accellarando/EmbeddedSystems/cad/motorMount.stl

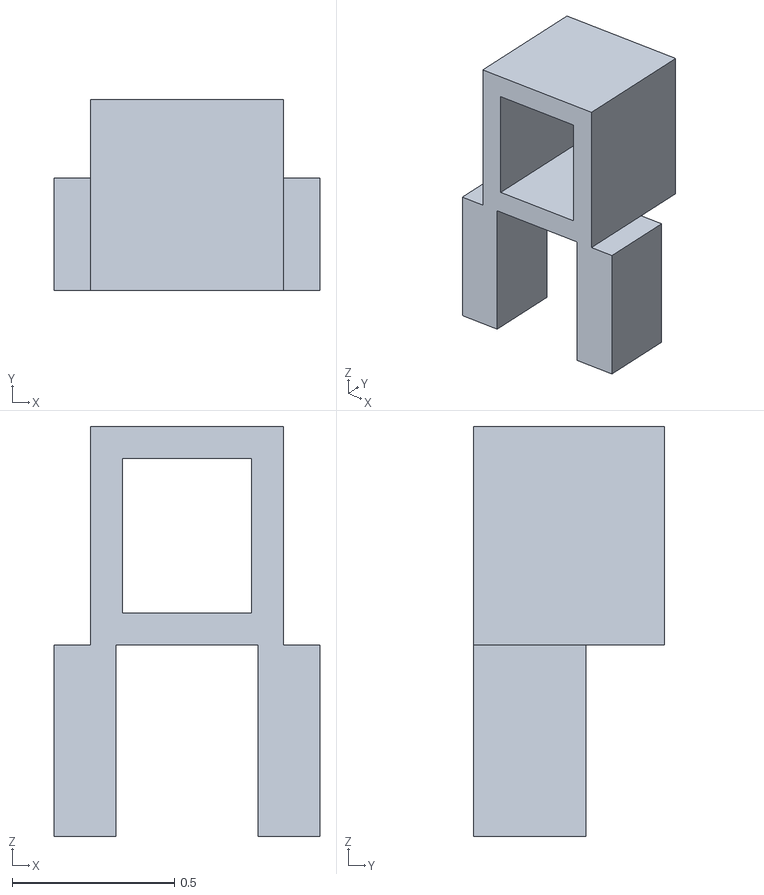
[picture p5: CAD file, 2023-04-11]
cad/motorMount.stl
0.82 x 0.591 x 1.26
