accellarando/EmbeddedSystems/(list of files, cad)

Other CAD files:
cad/Drawing1.idw
cad/motorMount.dwg
cad/motorMount.ipt
