accellarando/EmbeddedSystems/Motor_Driver.brd

## EAGLE design Motor_Driver.brd (2023-04-19)

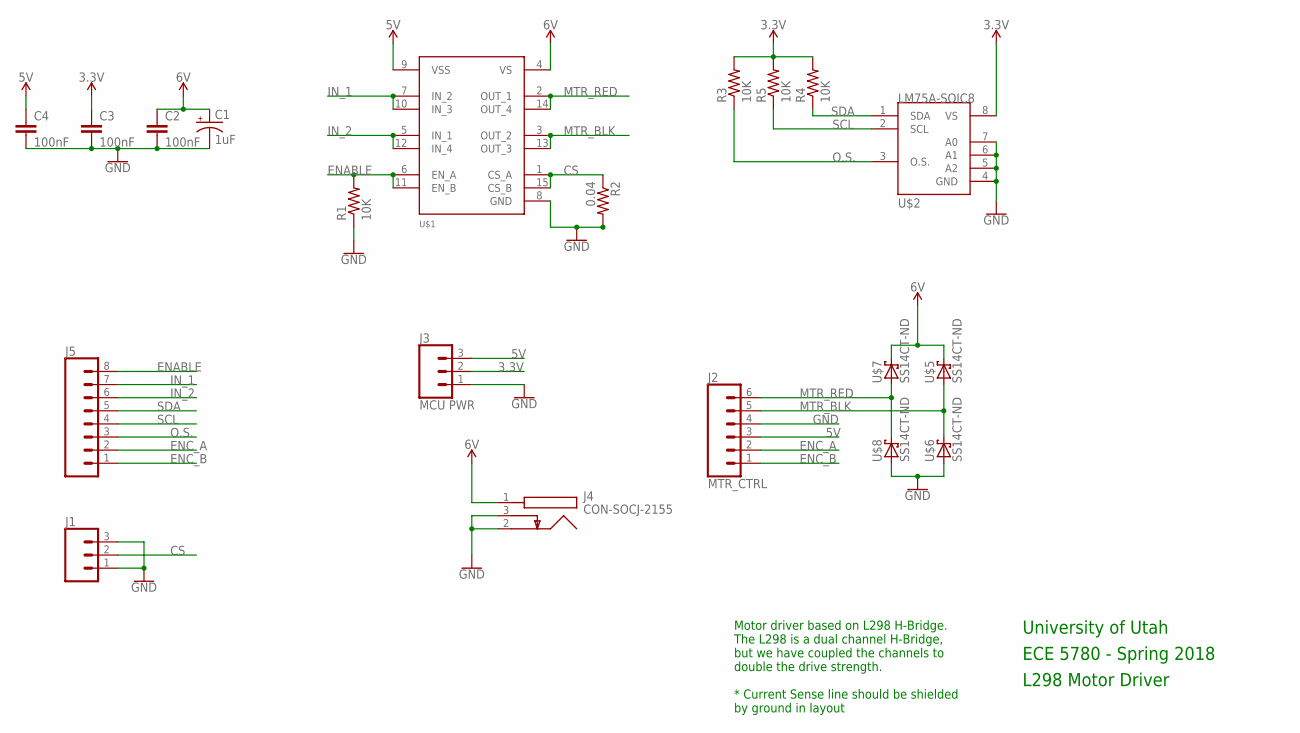
[picture p6: schematic Motor_Driver.sch]

Parts:
C1: 1uF; E2,5-6
C2, C3, C4: 100nF; C1206
J1: CONN_03; 1X03
J2: MTR_CTRL; 1X06
J3: MCU PWR; 1X03
J4: CON-SOCJ-2155; CONSOCJ2155
J5: CONN_08"; 1X08
R1, R3, R4, R5: 10K; M1206
R2: 0.04; M1206
U$1: L298N-MULTIWATT15
U$2: LM75A-SOIC8; SOIC-8
U$5, U$6, U$7, U$8: SS14CT-ND; SOD106A-W

Connections:
3.3V: C3.1, J3.2, R3.2, R4.2, R5.2, U$2.8 (VS)
5V: C4.1, J2.3, J3.3, U$1.9 (VSS)
CS: J1.2, R2.1, U$1.1 (CS_A), U$1.15 (CS_B)
ENABLE: J5.8, R1.2, U$1.6 (EN_A), U$1.11 (EN_B)
ENC_A: J2.2, J5.2
ENC_B: J2.1, J5.1
GND: C1.-, C2.2, C3.2, C4.2, J1.1, J1.3, J2.4, J3.1, J4.2, J4.3, R1.1, R2.2, U$1.8 (GND), U$2.4 (GND), U$2.5 (A2), U$2.6 (A1), U$2.7 (A0), U$6.A, U$8.A
IN_1: J5.7, U$1.7 (IN_2), U$1.10 (IN_3)
IN_2: J5.6, U$1.5 (IN_1), U$1.12 (IN_4)
MTR_BLK: J2.5, U$1.3 (OUT_2), U$1.13 (OUT_3), U$5.A, U$6.C
MTR_RED: J2.6, U$1.2 (OUT_1), U$1.14 (OUT_4), U$7.A, U$8.C
O.S.: J5.3, R3.1, U$2.3 (O.S.)
SCL: J5.4, R5.1, U$2.2 (SCL)
SDA: J5.5, R4.1, U$2.1 (SDA)
VCC: C1.+, C2.1, J4.1, U$1.4 (VS), U$5.C, U$7.C

Notes on the sheet:
University of Utah
ECE 5780 - Spring 2018
L298 Motor Driver
Motor driver based on L298 H-Bridge. The L298 is a dual channel H-Bridge, but we have coupled the channels to double the drive strength. * Current Sense line should be shielded by ground in layout

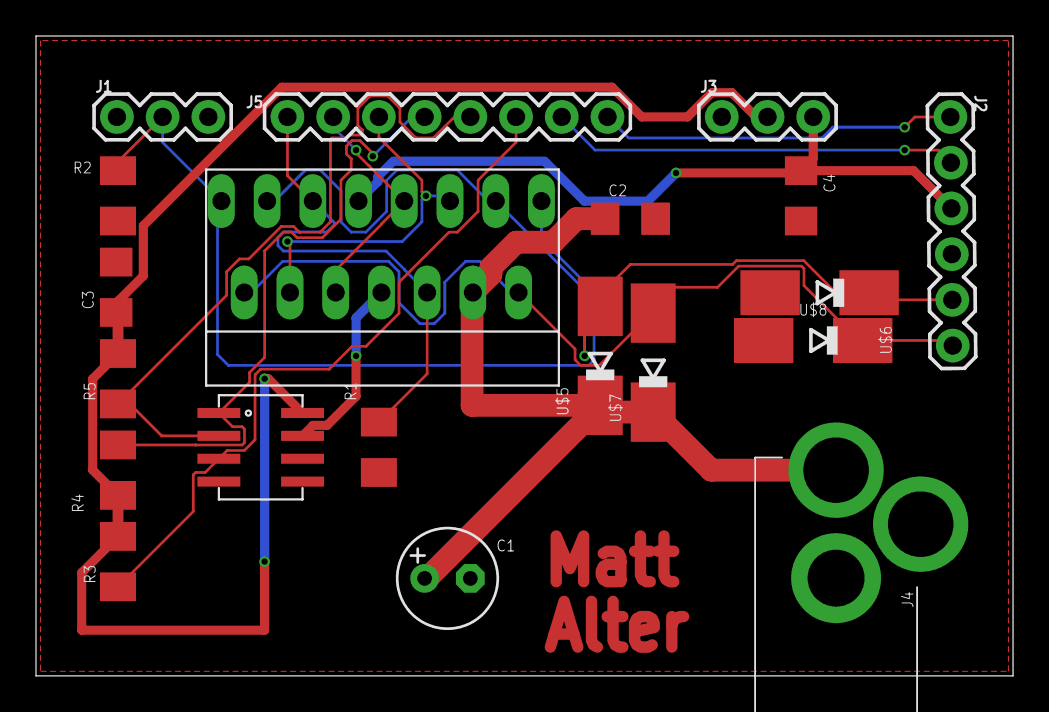
[picture p7: board Motor_Driver.brd from above]

Board: 2 copper layers, 54.3 x 35.6 mm, 20 parts (0 on the bottom side), 15 nets.
