accellarando/EmbeddedSystems/(commit log)

2023-04-11 added cad files
    [Drawing1.idw, motorMount.dwg, motorMount.ipt, motorMount.stl]
2023-04-18 added pin header/src files
2023-04-19 commented out extraneous ultrasonic init
2023-04-19 Added Lab7 Motor Files
2023-04-19 Added delays between motor toggles
2023-04-20 uart fixes
2023-04-20 motor refactor
2023-04-20 pwm offset for testing
2023-04-22 changed encoder timer channels
2023-04-25 Adds target distance setting and encoder checks
2023-04-25 added a print_debug flag
2023-04-26 Update to use absolute value of right motor speed in ratio calculation
2023-04-26 trying some other ultrasonic sensor stuff
2023-04-29 broke everything for a second but now it works again !
    [main.c, motor.c, motor.h]
2023-04-29 Update main.c
    Updated timeout for ultrasonic sensors so the value no longer overflows
    [main.c]
2023-04-29 Update main.c
    Changed the way we send the ultrasonic pulses.
2023-04-30 ultrasonics should be working now
2023-04-30 removed some debug prints
2023-05-02 readme additions
    [Left_Side_Moror.brd]
2023-05-02 images etc
    [Motor_Driver.brd]
2023-05-02 Add Wiring Diagram
2023-05-02 added wiring diagram link to readme
